bormilan/2022-likeabosch/hardwer design/309683255_502065191765211_17859476391939618_n.png

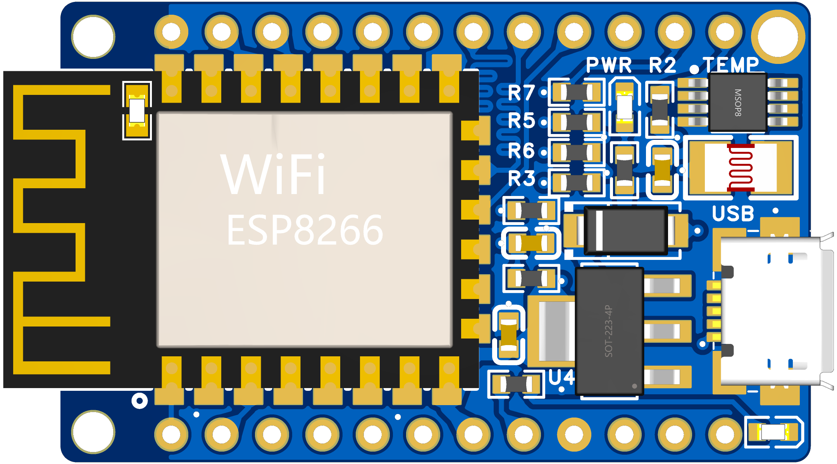
hardwer design/309683255_502065191765211_17859476391939618_n.png
