bormilan/2022-likeabosch/board_v2/images/back_normal.png

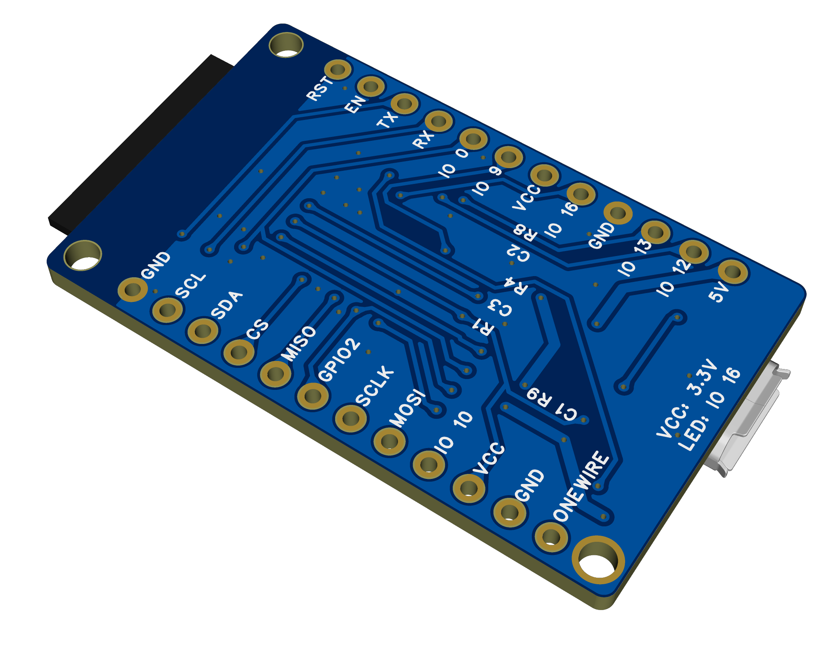
board_v2/images/back_normal.png
