bormilan/2022-likeabosch/board_v2/images/left.png

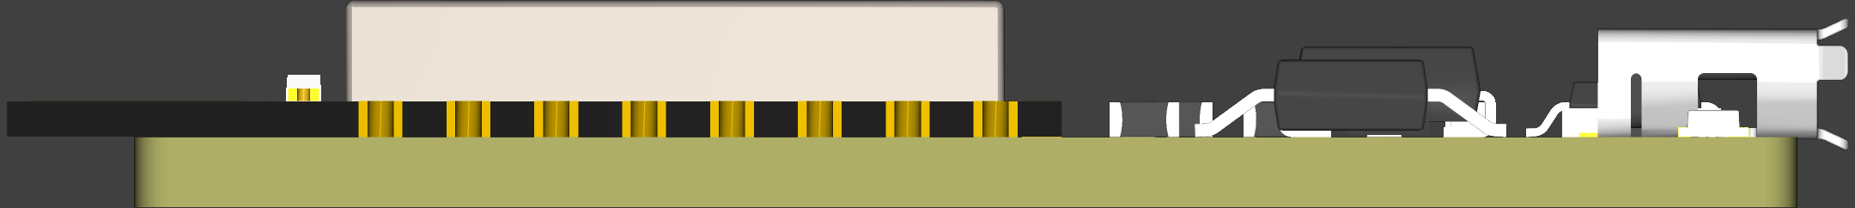
board_v2/images/left.png
