bormilan/2022-likeabosch/board_v2/images/right.png

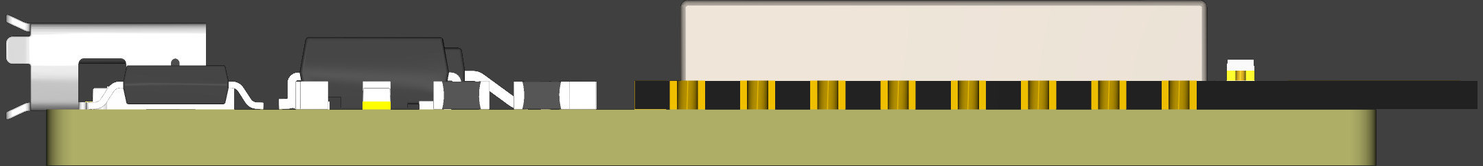
board_v2/images/right.png
