bormilan/2022-likeabosch/sensor_expenses.xlsx

Sheet: Munkalap1
LCSC Part Number | Manufacture Part Number | Manufacturer | Package | Description | RoHS | Order Qty. | Min\Mult Order Qty. | Unit Price | Order Price | Product Link
C82891 | ESP-12F(ESP8266MOD) | Ai-Thinker | WIFI Module | -90dBm 16dBm ESP32 PCB 板载天线 2.4GHz WIFI Module WiFi Modules ROHS | yes | 1000 | 1 | $1.6525 | $1652.5 | https://assets.lcsc.com/images/lcsc/96x96/20220805_Ai-Thinker-ESP-12F-ESP8266MOD_C82891_front.jpg
C2904883 | GT36549 | JCHL(Shenzhen Jing Chuang He Li Tech) | SMD,3.6x2.4x0.65mm | SMD,3.6x2.4x0.65mm Photoresistors ROHS | yes | 1000 | 1 | $0.0982 | $98.2 | https://assets.lcsc.com/images/lcsc/96x96/20211021_JCHL-Shenzhen-Jing-Chuang-He-Li-Tech-GT36549_C2904883_front.jpg
C695836 | DS18B20U | UMW(Youtai Semiconductor Co., Ltd.) | MSOP-8 | MSOP-8 Temperature Sensors ROHS | yes | 1000 | 1 | $0.6094 | $609.4 | https://assets.lcsc.com/images/lcsc/96x96/20200707_UMW-Youtai-Semiconductor-Co---Ltd--DS18B20U_C695836_front.jpg
C2907166 | FRC0603J472 TS | FOJAN | 0603 | 100mW Thick Film Resistors 50V ±100ppm/℃ ±5% -55℃~+155℃ 4.7kΩ 0603 Chip Resistor - Surface Mount ROHS | yes | 1000 | 100 | $0.0006 | $0.6 | https://assets.lcsc.com/images/lcsc/96x96/20211107_FOJAN-FRC0603J472-TS_C2907166_front.jpg
C173386 | AMS1117-3.3V | Shenzhen Fuman Elec | SOT-223 | 75dB@(10kHz) 800mA 1.5V@(700mA) Fixed 3.3V~3.3V Positive 1 12V SOT-223 Linear Voltage Regulators (LDO) ROHS | yes | 1000 | 5 | $0.0399 | $39.9 | https://assets.lcsc.com/images/lcsc/96x96/20220413_Shenzhen-Fuman-Elec-AMS1117-3-3V_C173386_front.jpg
C92487 | CL10A106MO8NQNC | Samsung Electro-Mechanics | 0603 | 16V 10uF X5R ±20% 0603 Multilayer Ceramic Capacitors MLCC - SMD/SMT ROHS | yes | 1000 | 50 | $0.0090 | $9.0 | https://assets.lcsc.com/images/lcsc/96x96/20180914_Samsung-Electro-Mechanics-CL10A106MO8NQNC_C92487_front.jpg
C727081 | 1N4007 | TWGMC | SMA(DO-214AC) | 1A Single 5uA@1kV 1kV 1.1V@1A SMA(DO-214AC) Diodes - General Purpose ROHS | yes | 1000 | 50 | $0.0087 | $8.7 | https://assets.lcsc.com/images/lcsc/96x96/20200916_TWGMC-1N4007_C727081_front.jpg
C132564 | 10118192-0001LF | Amphenol ICC | SMD | USB 2.0 1 Surface Mount 5 Female Micro-B SMD USB Connectors ROHS | yes | 1000 | 1 | $0.1474 | $147.4 | https://assets.lcsc.com/images/lcsc/96x96/20180914_Amphenol-ICC-10118192-0001LF_C132564_front.jpg
C114659 | RC0603FR-0712KL | YAGEO | 0603 | 100mW Thick Film Resistors 75V ±100ppm/℃ ±1% -55℃~+155℃ 12kΩ 0603 Chip Resistor - Surface Mount ROHS | yes | 1000 | 100 | $0.0011 | $1.1 | https://assets.lcsc.com/images/lcsc/96x96/20180914_YAGEO-RC0603FR-0712KL_C114659_front_10.jpg
C282071 | CC0603CRNPO9BN4R7 | YAGEO | 0603 | 50V 4.7pF NP0 ±0.25pF 0603 Multilayer Ceramic Capacitors MLCC - SMD/SMT ROHS | yes | 1000 | 100 | $0.0031 | $3.1 | https://assets.lcsc.com/images/lcsc/96x96/20180922_YAGEO-CC0603CRNPO9BN4R7_C282071_front.jpg
C965799 | XL-1608SURC-06 | XINGLIGHT | 0603 | 25mA 60mcd 2V 623nm Colorless transparence -30℃~+85℃ Positive post 617nm~621nm Red 120° 55mW 0603 Light Emitting Diodes (LED) ROHS | yes | 1000 | 100 | $0.0029 | $2.9 | https://assets.lcsc.com/images/lcsc/96x96/20201230_XINGLIGHT-XL-1608SURC-06_C965799_front.jpg
C105588 | RC0603FR-07100RL | YAGEO | 0603 | 100mW Thick Film Resistors 75V ±100ppm/℃ ±1% -55℃~+155℃ 100Ω 0603 Chip Resistor - Surface Mount ROHS | yes | 1000 | 100 | $0.0008 | $0.8 | https://assets.lcsc.com/images/lcsc/96x96/20200707_YAGEO-RC0603FR-07100RL_C105588_front.jpg
C105881 | RC0603FR-07330RL | YAGEO | 0603 | 100mW Thick Film Resistors 75V ±100ppm/℃ ±1% -55℃~+155℃ 330Ω 0603 Chip Resistor - Surface Mount ROHS | yes | 1000 | 100 | $0.0011 | $1.1 | https://assets.lcsc.com/images/lcsc/96x96/20180914_YAGEO-RC0603FR-07330RL_C105881_front.jpg
C14675 | RC0603FR-07100KL | YAGEO | 0603 | 100mW Thick Film Resistors 75V ±100ppm/℃ ±1% -55℃~+155℃ 100kΩ 0603 Chip Resistor - Surface Mount ROHS | yes | 1000 | 100 | $0.0009 | $0.9 | https://assets.lcsc.com/images/lcsc/96x96/20180914_YAGEO-RC0603FR-07100KL_C14675_front.jpg
 |  |  |  |  |  |  |  | TOTAL: | $2575.60

Sheet: Munkalap2
No. | Quantity | Device | Designator | Footprint | Value | Manufacturer | LCSC Part ID | Description | $ / 1000 Pcs
1 | 2 | CL10A106MO8NQNC | C1,C2 | 0603 | 10uF | SAMSUNG(三星) | C92487 | 10uF ±20% 16V
2 | 1 | CC0603CRNPO9BN4R7 | C3 | 0603 | 4.7pF | YAGEO(国巨) | C282071 | 4.7pF ±0.25pF 50V
3 | 1 | 1N4007 | D1 | SMA_L4.3-W2.5-LS5.0-RD |  | TWGMC(台湾迪嘉) | C727081 | 1kV 1A 1.1V@1A
4 | 2 | XL-1608SURC-06 | LED1,LED2 | 0603 |  | XINGLIGHT(成兴光) | C965799 | 0603 LED (Iv=38-75mcd(Typ) @IF=25mA)
5 | 1 | RC0603FR-07100KL | R1 | 0603 | 100kΩ | YAGEO(国巨) | C14675 | 100kΩ ±1% 100mW
6 | 1 | FRC0603J472 TS | R2 | 0603 | 4.7kΩ | FOJAN(富捷) | C2907166 | 4.7KΩ ±5%
7 | 5 | RC0603FR-0712KL | R3,R4,R5,R6,R7 | 0603 | 12kΩ | YAGEO(国巨) | C114659 | 12kΩ ±1%
8 | 1 | RC0603FR-07100RL | R8 | 0603 | 100Ω | YAGEO(国巨) | C105588 | 100Ω ±1%
9 | 1 | RC0603FR-07330RL | R9 | 0603 | 330Ω | YAGEO(国巨) | C105881 | 330Ω ±1% 100mW
10 | 1 | ESP-12F | U1 | WIFIM-SMD_ESP-12F-ESP8266MOD |  | Ai-Thinker(安信可) | C82891 | ESP-12F(ESP8266MOD)
11 | 1 | GT36549 | U2 | RES-SMD_L3.6-W2.4 |  | JCHL(晶创和立) | C2904883 | GT36549
12 | 1 | DS18B20U | U3 | MSOP-8_L3.0-W3.0-P0.65-LS4.9-BL |  | UMW(友台半导体) | C695836 | Temperature Sensor
13 | 1 | AMS1117-3.3V | U4 | SOT-223_L6.5-W3.5-P2.30-LS7.0-BR |  | FM富满 | C173386 | LDO VinMax=12V Vout=3.3V 800mA 75dB@(10kHz) (SC1117-3.3V)
14 | 1 | 10118192-0001LF | USB1 | MICRO-USB-SMD_10118192-0001LF_1 |  | Amphenol | C132564 | Micro-B 母座 卧贴
