bormilan/2022-likeabosch/board_v2/EXPORTED_DXF_PCB.dxf

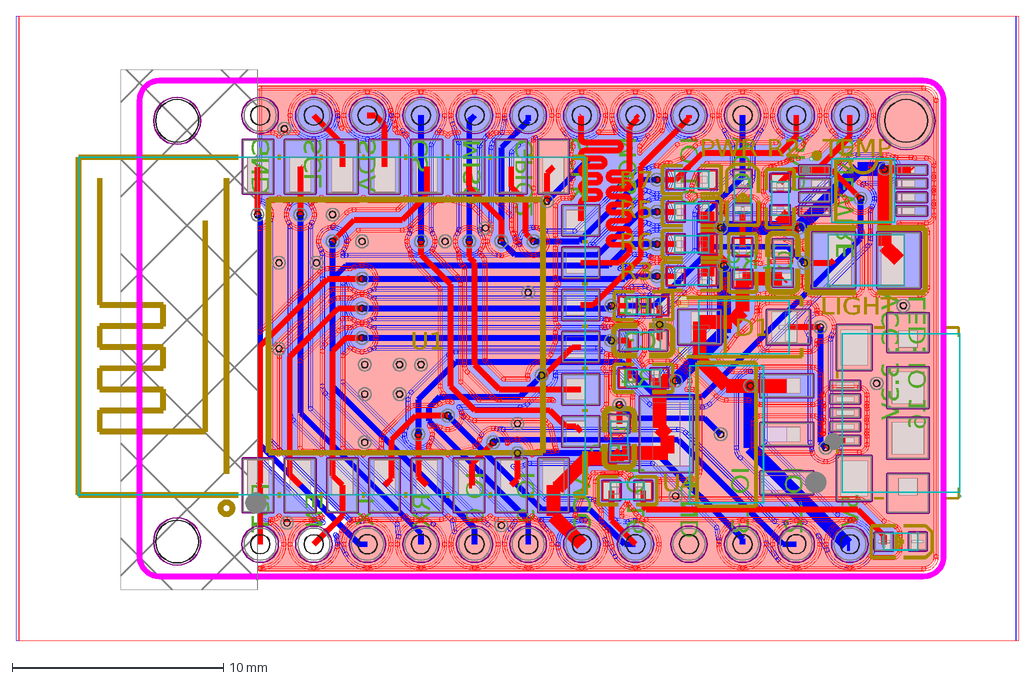
[picture p14: CAD file, 2022-10-02]
board_v2/EXPORTED_DXF_PCB.dxf
R1
GND
SCL
CS
SDA
MOSI
SCLK
GPIO2
MISO
IO 10
VCC
ONEWIRE
5V
IO 12
IO 13
IO 16
IO 9
IO 0
RX
EN
TX
RST
VCC: 3.3V
C2
C1
R4
C3
LED: IO 16
R8
R9
U1
LIGHT
TEMP
R2
U4
D1
R3
R5
R6
R7
PWR
