bormilan/2022-likeabosch/ESP32_Cam_Case/case_bottom.stl

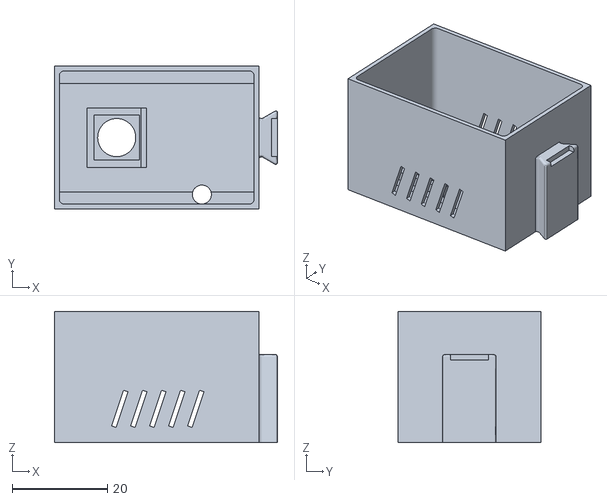
[picture p15: CAD file, 2022-10-01]
ESP32_Cam_Case/case_bottom.stl
46.9 x 30.0 x 27.6
