bormilan/2022-likeabosch/ESP32_Cam_Case/rail.stl

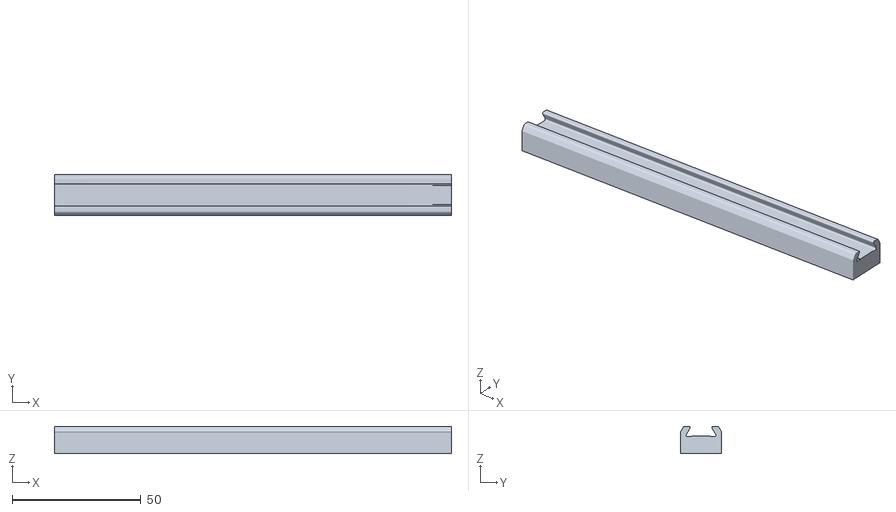
[picture p16: CAD file, 2022-10-01]
ESP32_Cam_Case/rail.stl
154.2 x 16.1 x 10.7
