bormilan/2022-likeabosch/ESP32_Cam_Case/case_top.stl

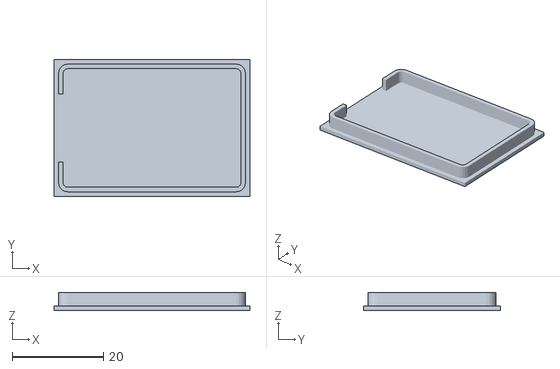
[picture p17: CAD file, 2022-10-01]
ESP32_Cam_Case/case_top.stl
43.0 x 30.0 x 4.00
