bormilan/2022-likeabosch/board_v2/SCHEMATIC_ESP_temp_light.pdf

MicroUSB-B + PWR LED | ESP8266 (ESP-12F) | Pullup + Pulldown resistors

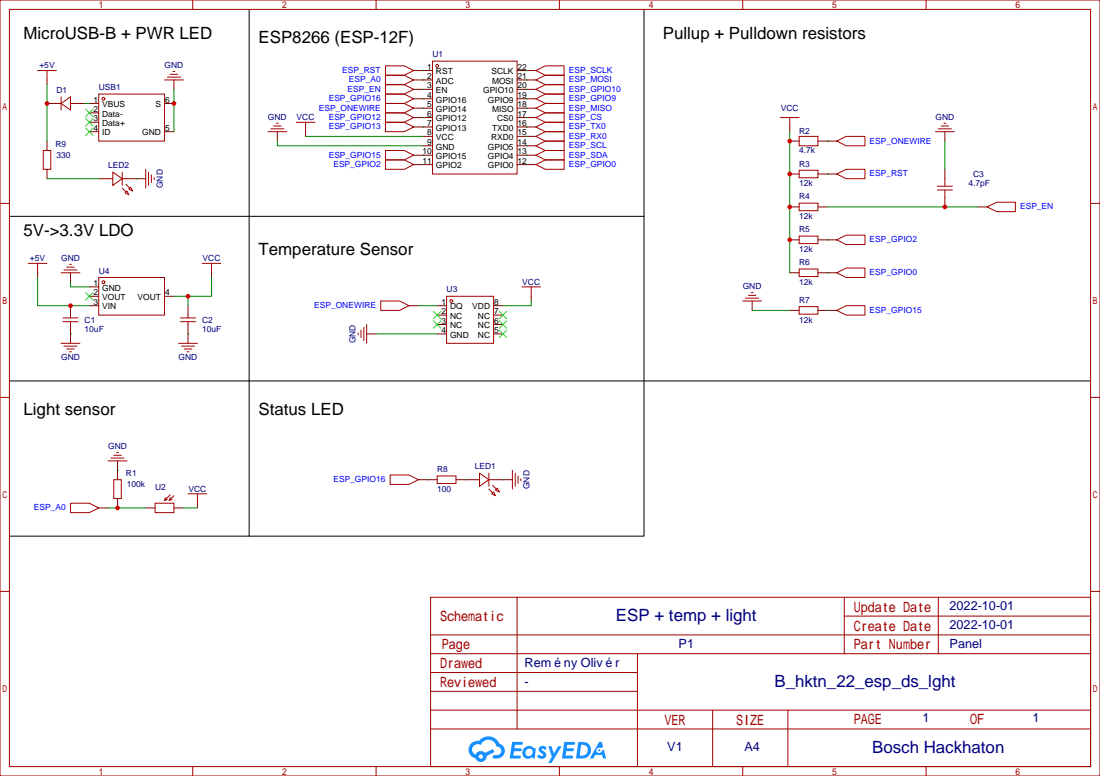
[picture p18: page 1]
