bormilan/2022-likeabosch/hardwer design/SCH_ESP-temp-light_2022-10-01.pdf

MicroUSB-B + PWR LED | ESP8266 (ESP-12F) | Pullup + Pulldown resistors

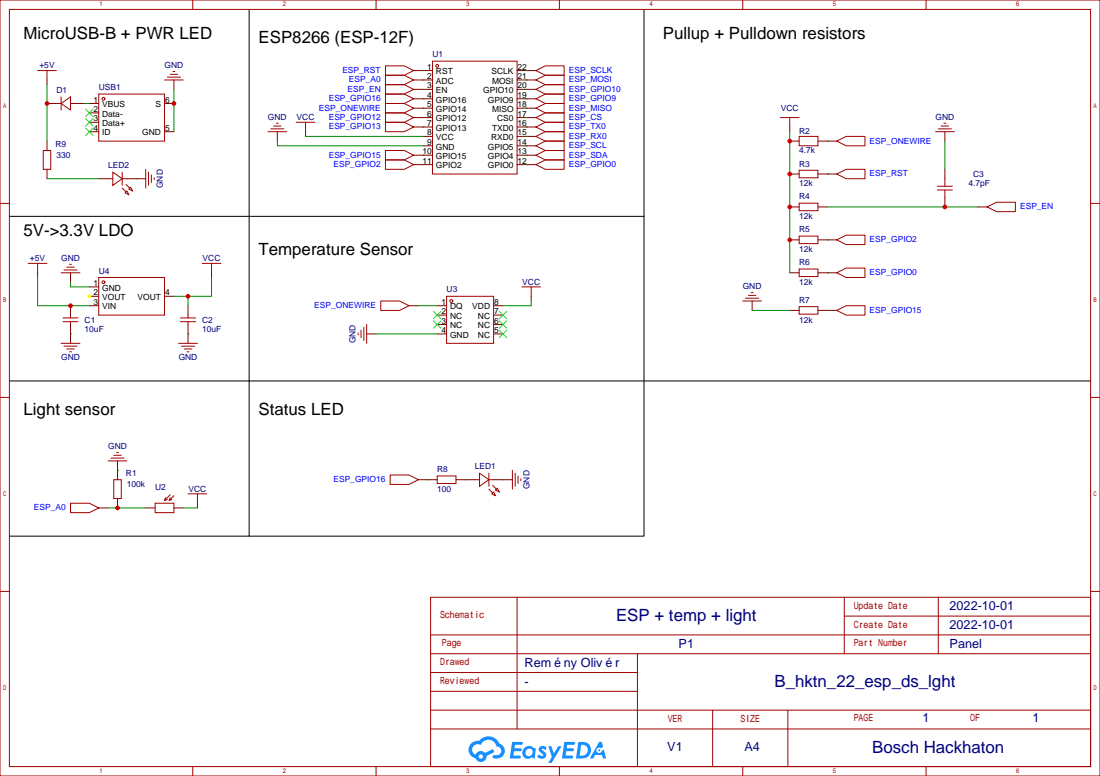
[picture p19: page 1]
