bormilan/2022-likeabosch/board_v2/PCB_layers_and_composites.pdf

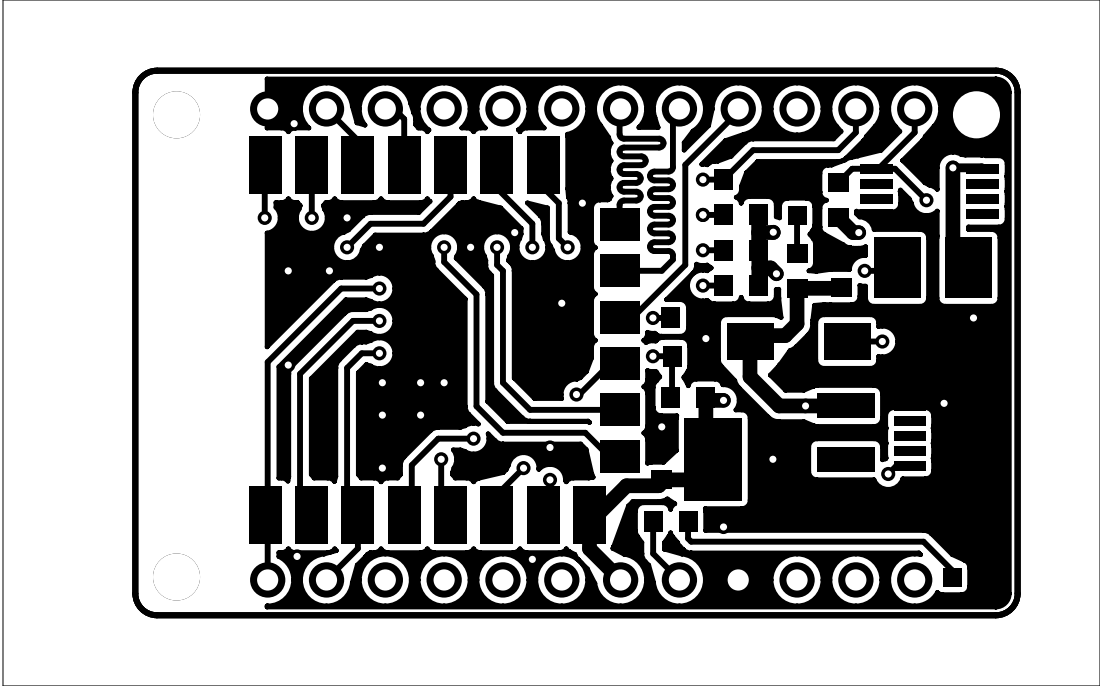
[picture p20: page 1]

# R2TEMP

# R7 PWR

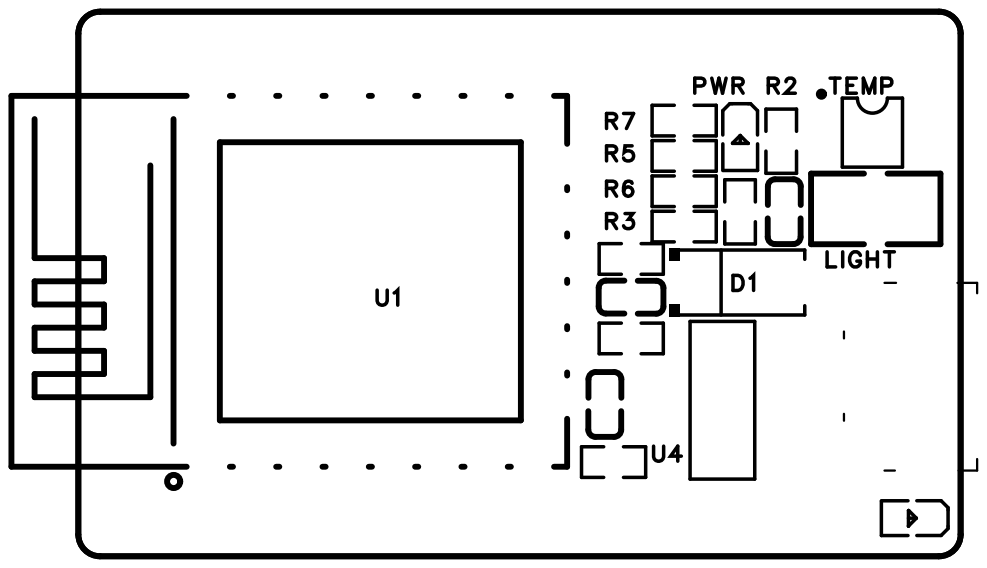
[picture p21: page 2]

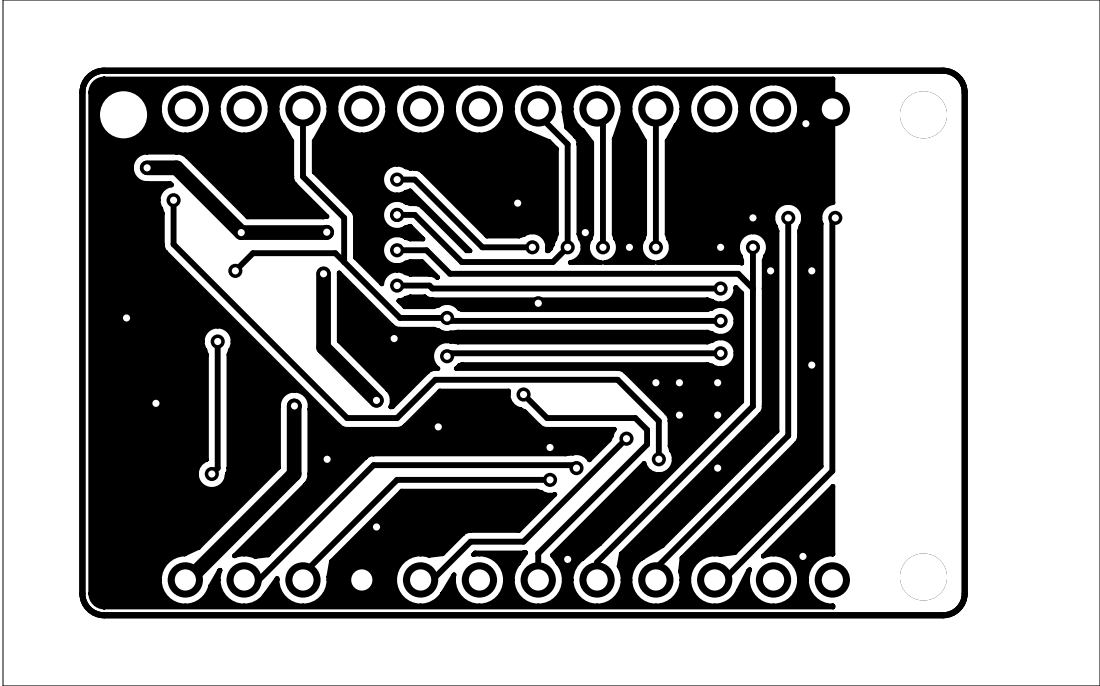
[picture p22: page 3]

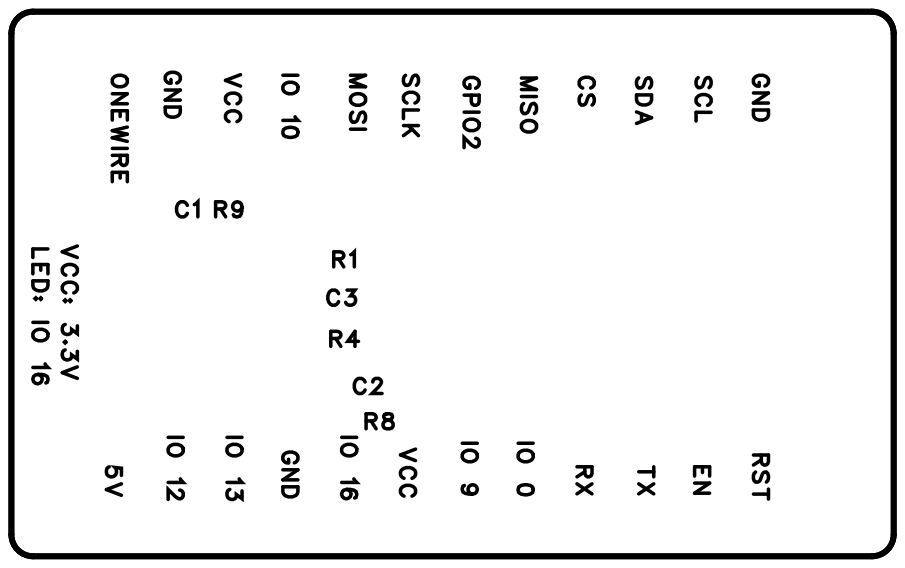
[picture p23: page 4]

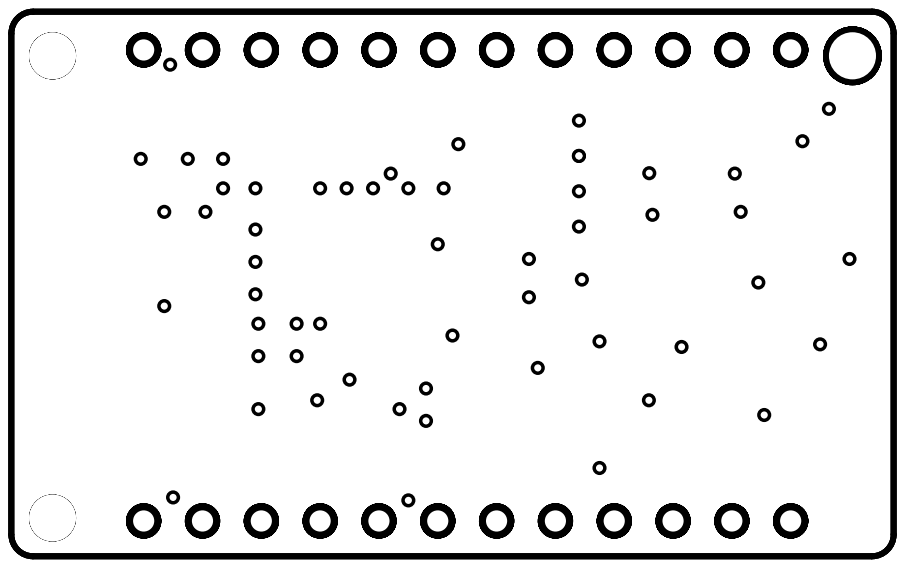
[picture p24: page 5]

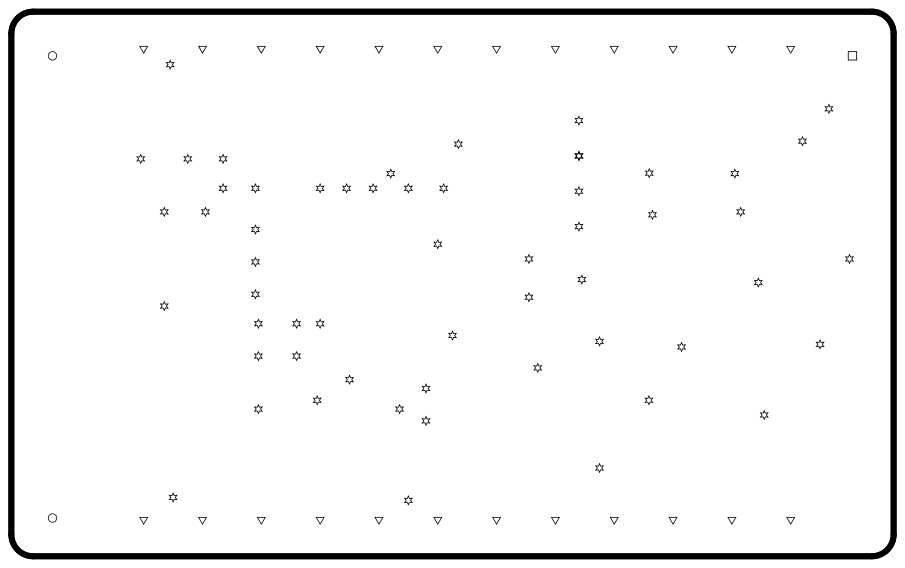
[picture p25: page 6]

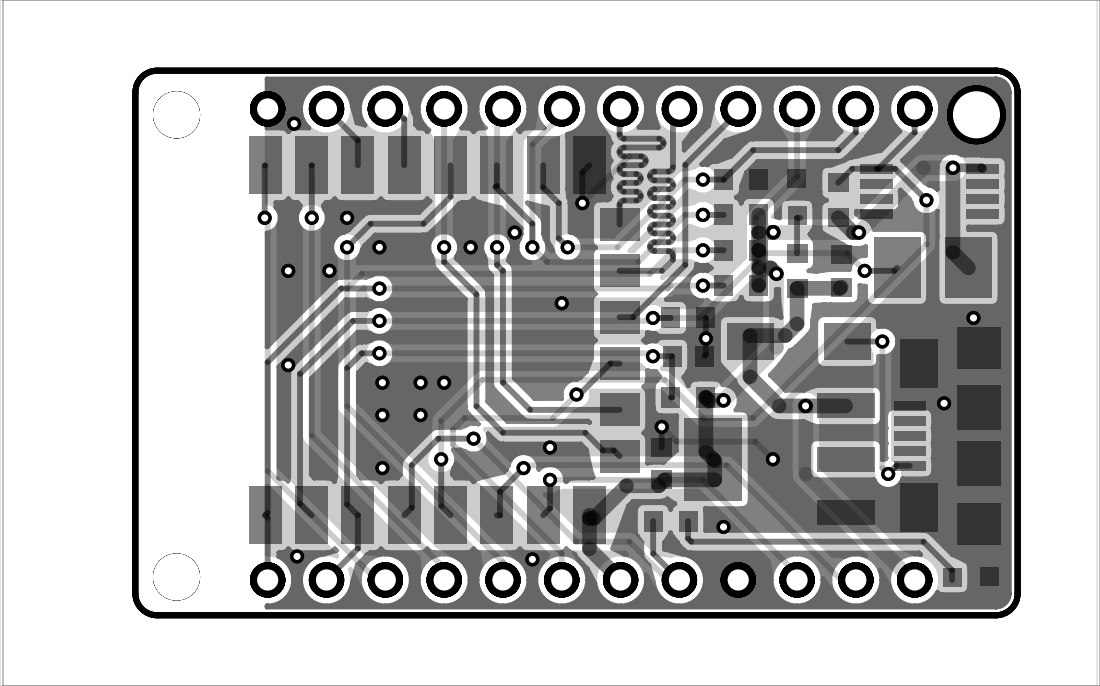
[picture p26: page 7]

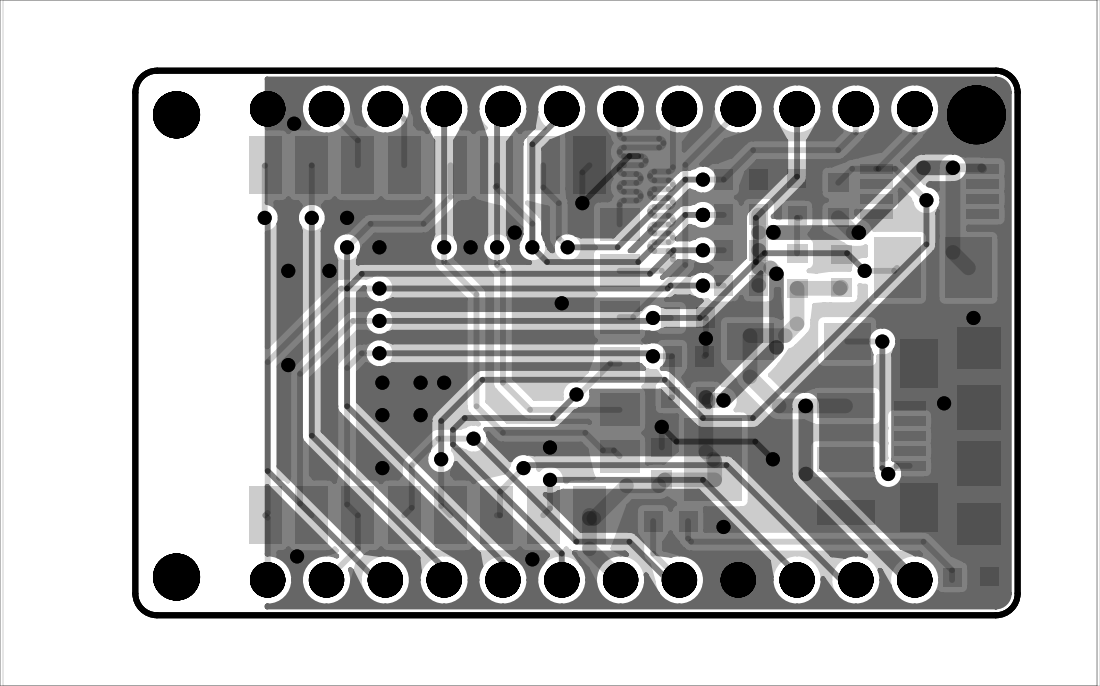
[picture p27: page 8]

# R2TEMP

# R7 PWR

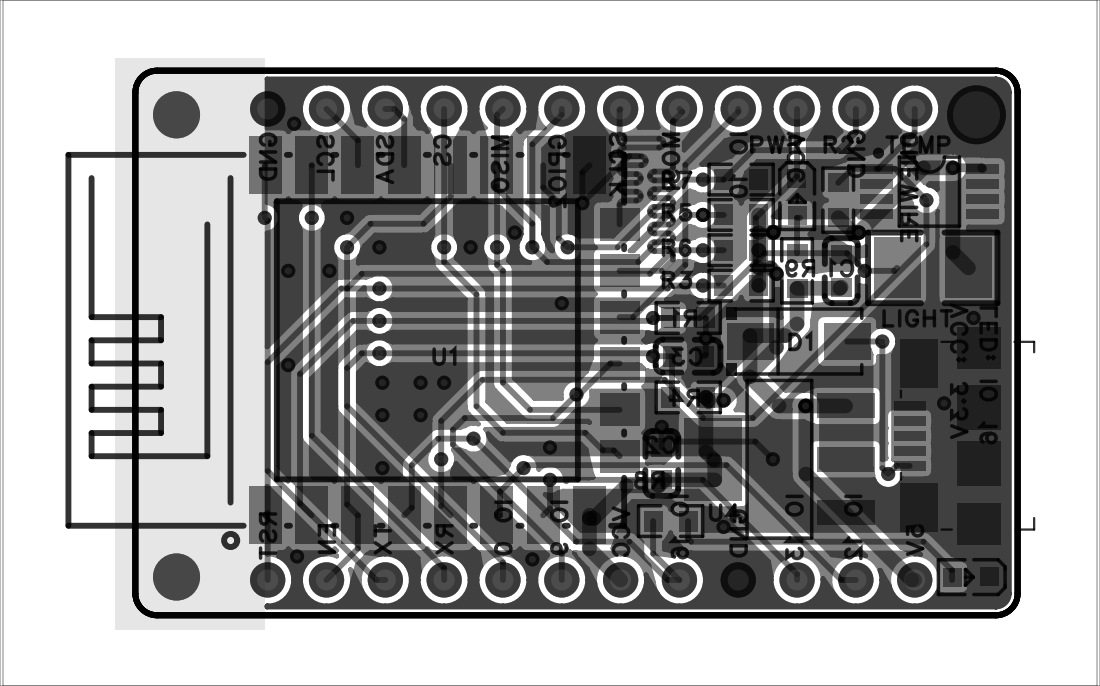
[picture p28: page 9]

# R2TEMP

# R7 PWR

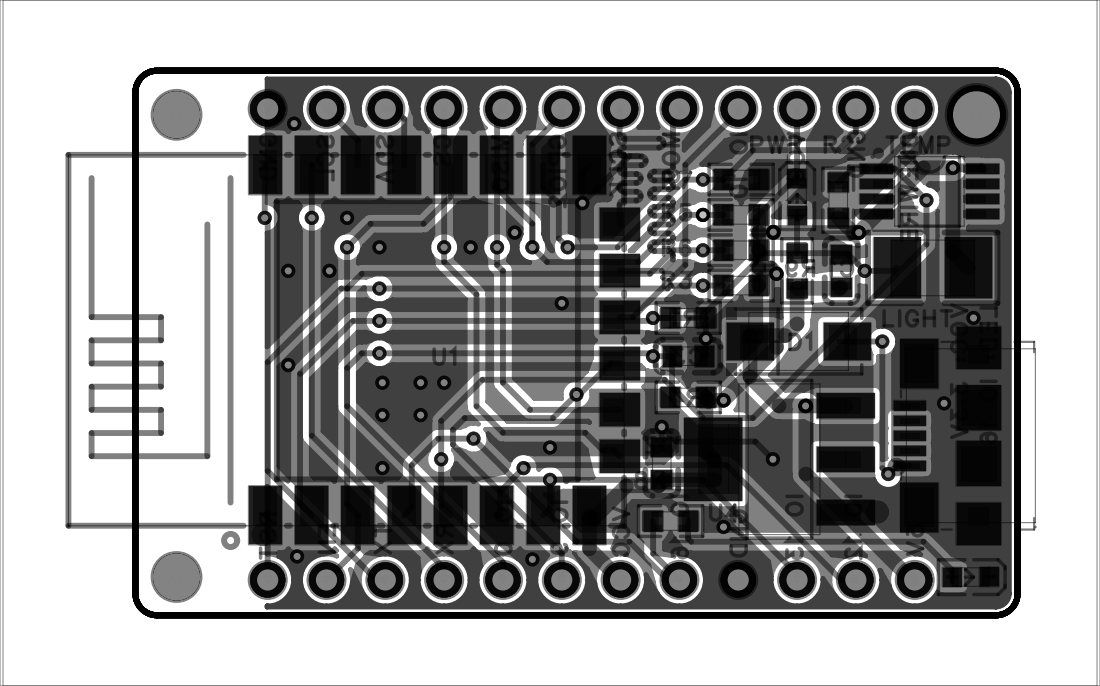
[picture p29: page 10]
