bormilan/2022-likeabosch/(commit log)

2022-10-01 custom sensor
    [Drill_PTH_Through.DRL, Gerber_BoardOutlineLayer.GKO, Gerber_BottomLayer.GBL, Gerber_BottomSilkscreenLayer.GBO, Gerber_BottomSolderMaskLayer.GBS, Gerber_TopLayer.GTL, Gerber_TopPasteMaskLayer.GTP, Gerber_TopSilkscreenLayer.GTO]
2022-10-01 3D case
    [case_bottom.stl, case_top.stl, rail.stl]
